Kosmasss/Stylus/3D PRINTABLES/Charching-station.obj

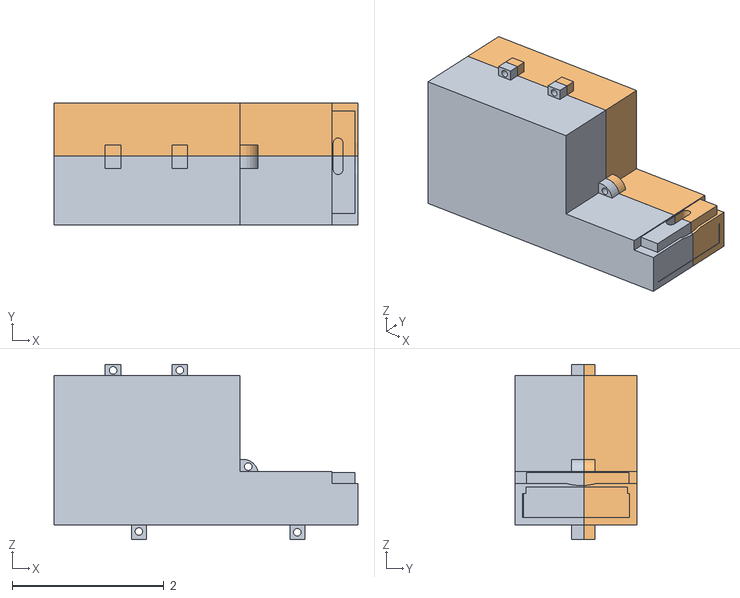
[picture p1: CAD file, 2025-06-29]
3D PRINTABLES/Charching-station.obj
4.00 x 1.61 x 2.31
