Kosmasss/Stylus/3D PRINTABLES/Stylus case2.obj

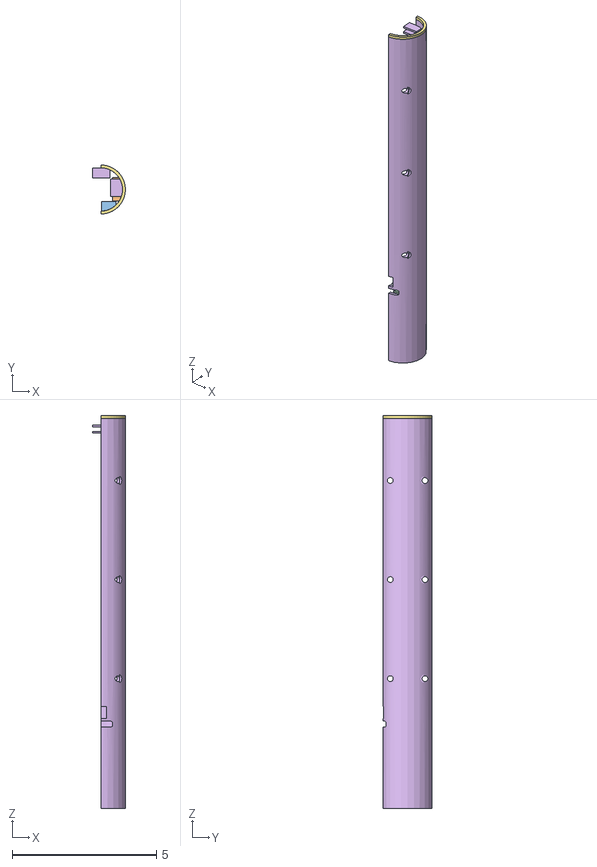
[picture p2: CAD file, 2025-06-21]
3D PRINTABLES/Stylus case2.obj
1.13 x 1.70 x 13.6
