Kosmasss/Stylus/3D PRINTABLES/Stylus case1.obj

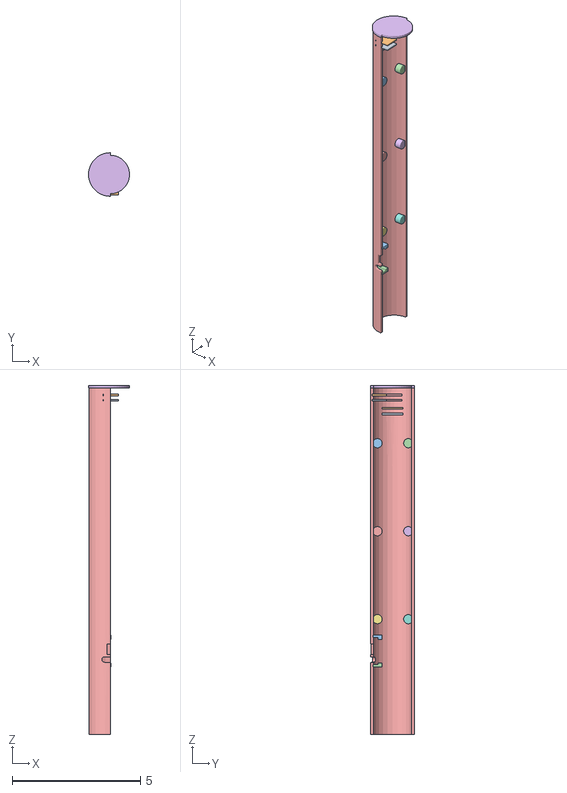
[picture p3: CAD file, 2025-06-21]
3D PRINTABLES/Stylus case1.obj
1.60 x 1.70 x 13.6
