Kosmasss/Stylus/PCB-SCHEMATICS/V3 schem+PCB/SCH_V3.pdf

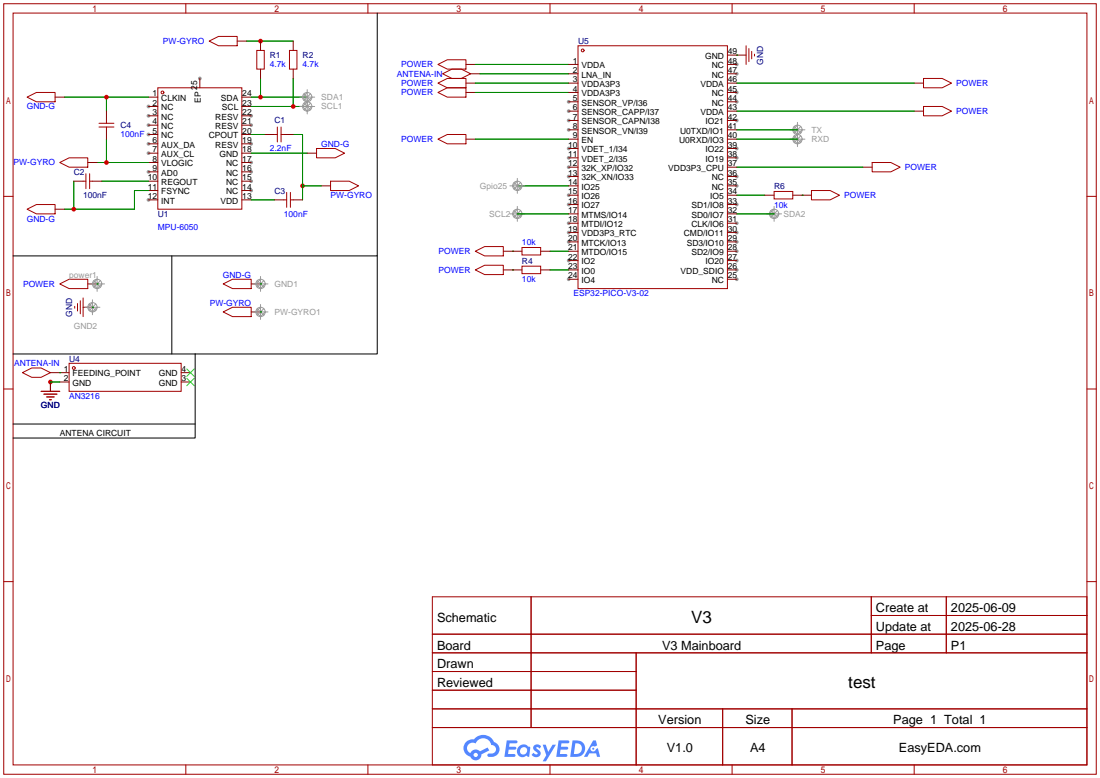
[picture p4: page 1]

Schematic | V3 | Create at | 2025-06-09

Update at | 2025-06-28

Board | V3 Mainboard | Page | P1
Drawn | | test
Reviewed

Version | Size | Page 1 Total 1
V1.0 | A4 | EasyEDA.com
