Kosmasss/Stylus/PCB-SCHEMATICS/Charging-Station/SCH_Charching_statio_V1.pdf

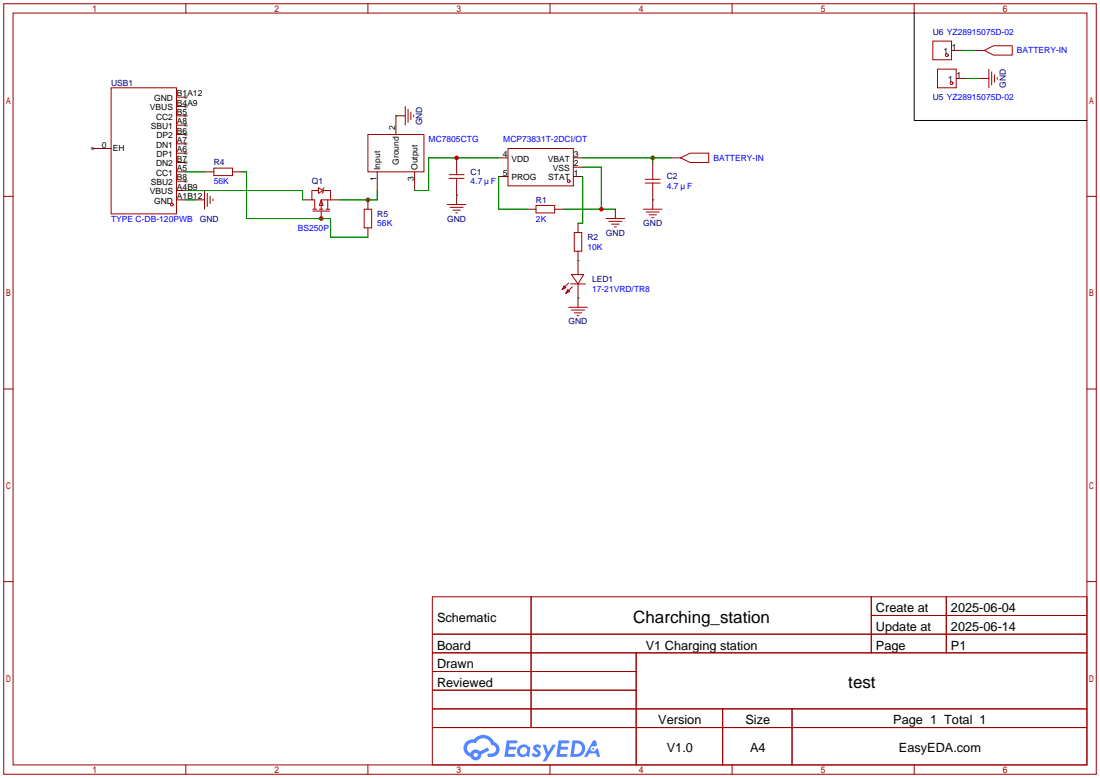
[picture p5: page 1]

Schematic | Charching_station | Create at | 2025-06-04

Update at | 2025-06-14

Board | V1 Charging station | Page | P1
Drawn | | test
Reviewed

Version | Size | Page 1 Total 1
V1.0 | A4 | EasyEDA.com
