Kosmasss/Stylus/PCB-SCHEMATICS/V1 shem+pcb/SCH_V1_2025-06-04.pdf

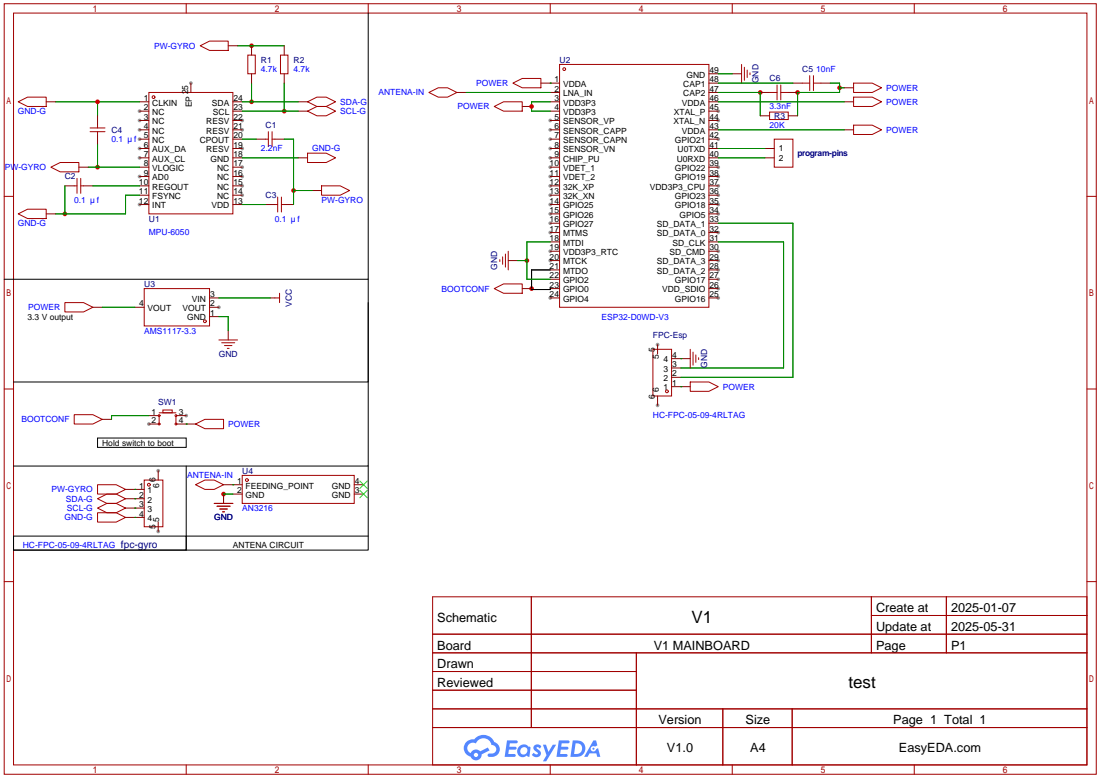
[picture p6: page 1]

Hold switch to boot

HC-FPC-05-09-4RLTAG fpc-gyro

Schematic | V1 | Create at | 2025-01-07

Update at | 2025-05-31

Board | V1 MAINBOARD | Page | P1
Drawn | | test
Reviewed

Version | Size | Page 1 Total 1
V1.0 | A4 | EasyEDA.com
