Kosmasss/Stylus/PCB-SCHEMATICS/Power-etc/V1/SCH_power-etc_V1.pdf

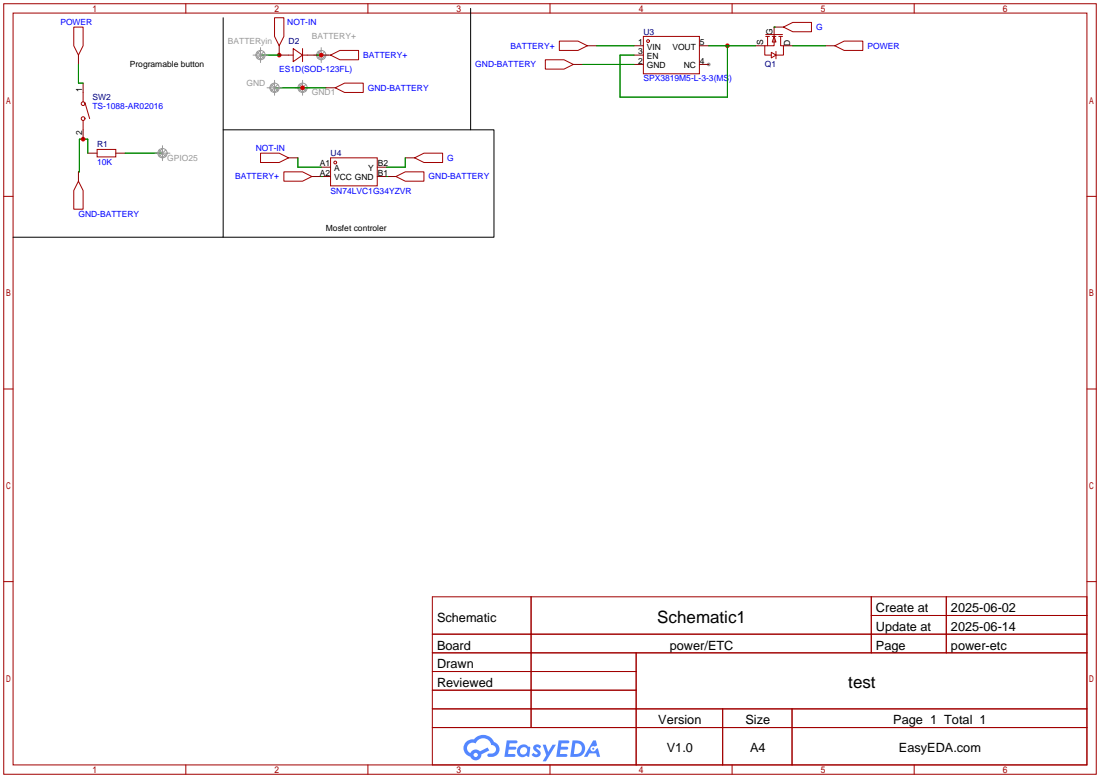
[picture p7: page 1]

Schematic | Schematic1 | Create at | 2025-06-02

Update at | 2025-06-14

Board | power/ETC | Page | power-etc
Drawn | | test
Reviewed

Version | Size | Page 1 Total 1
V1.0 | A4 | EasyEDA.com
