Kosmasss/Stylus/PCB-SCHEMATICS/Charging-Station/PCB-Charching_station_V1.pdf

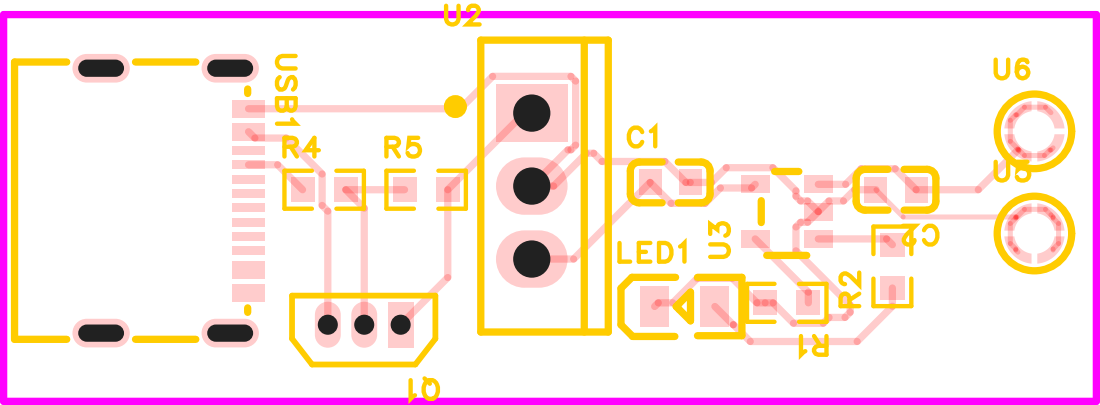
[picture p8: page 1]

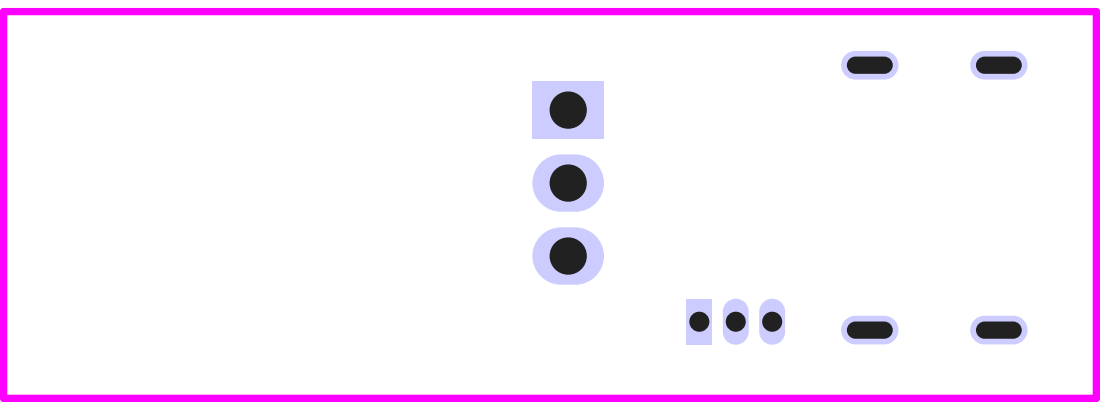
[picture p9: page 2]
