Kosmasss/Stylus/PCB-SCHEMATICS/V1 shem+pcb/PCB_PCB3_2025-06-04.pdf

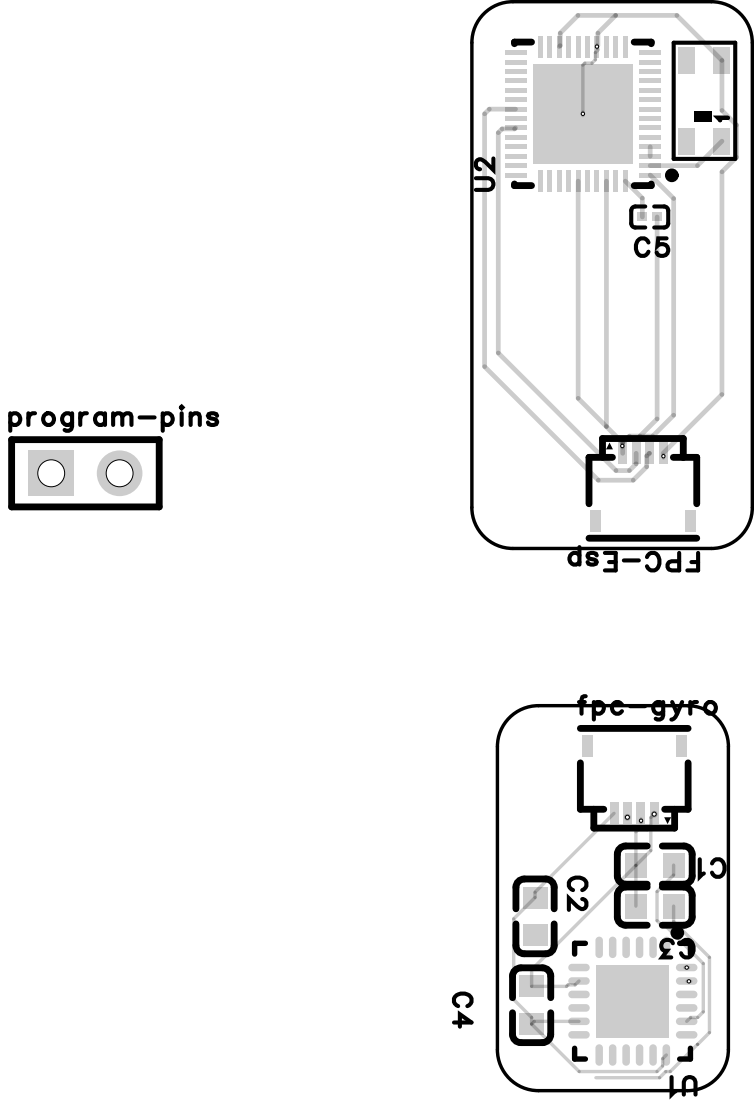
[picture p10: page 1]

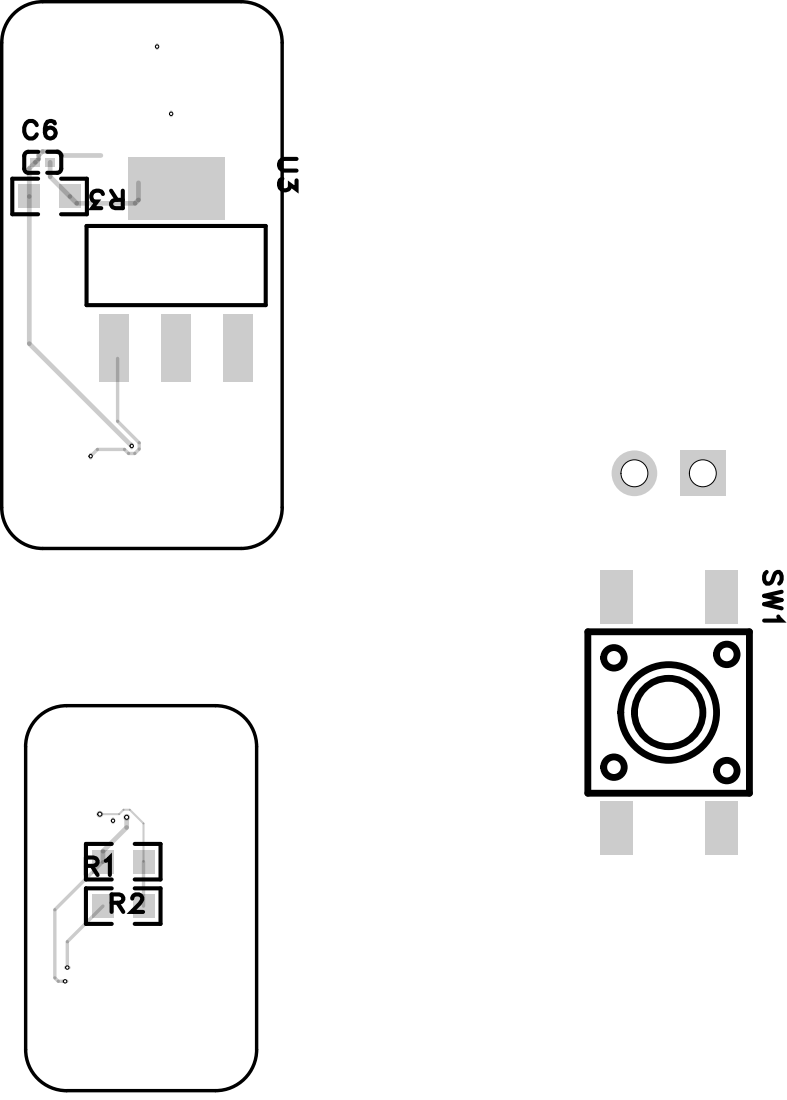
[picture p11: page 2]
