Kosmasss/Stylus/PCB-SCHEMATICS/V2 schem+PCB/PCB-V2-2025-06-05.pdf

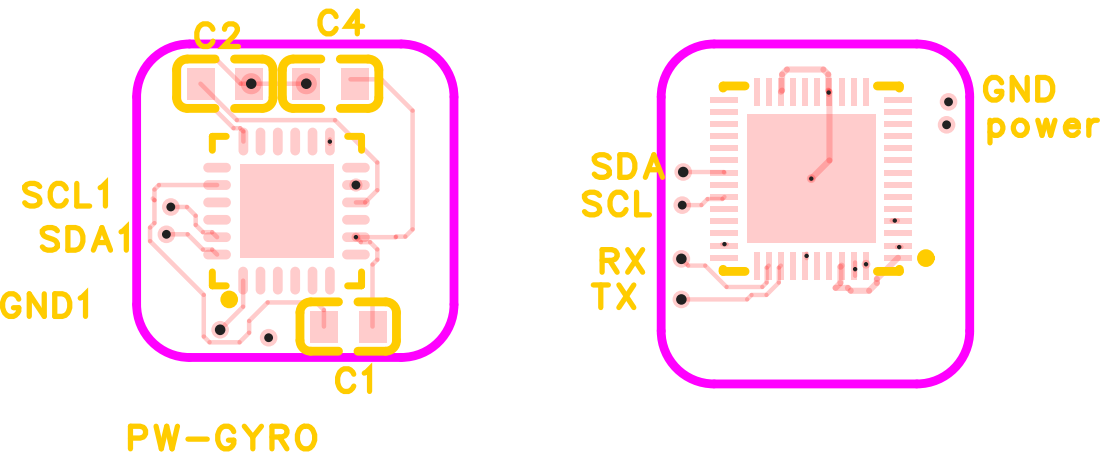
[picture p12: page 1]

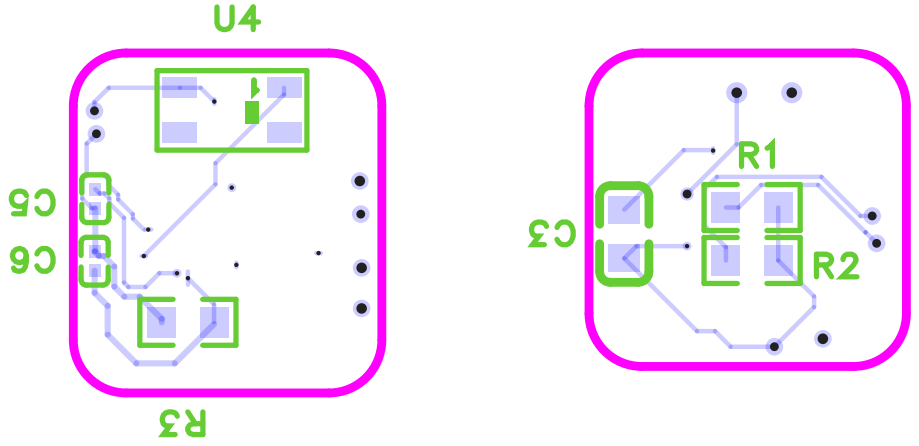
[picture p13: page 2]

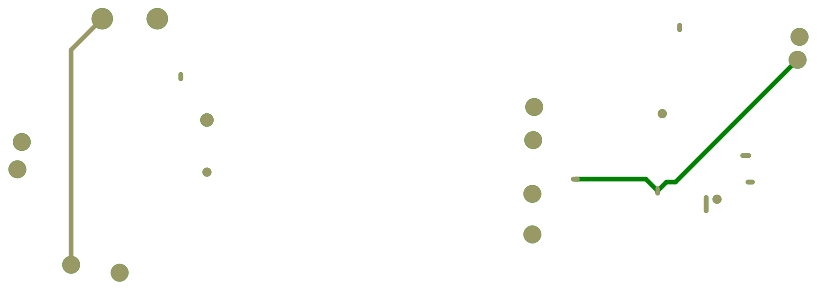
[picture p14: page 4]
